pilsbot/overvoltage_protection/render/pcb.png

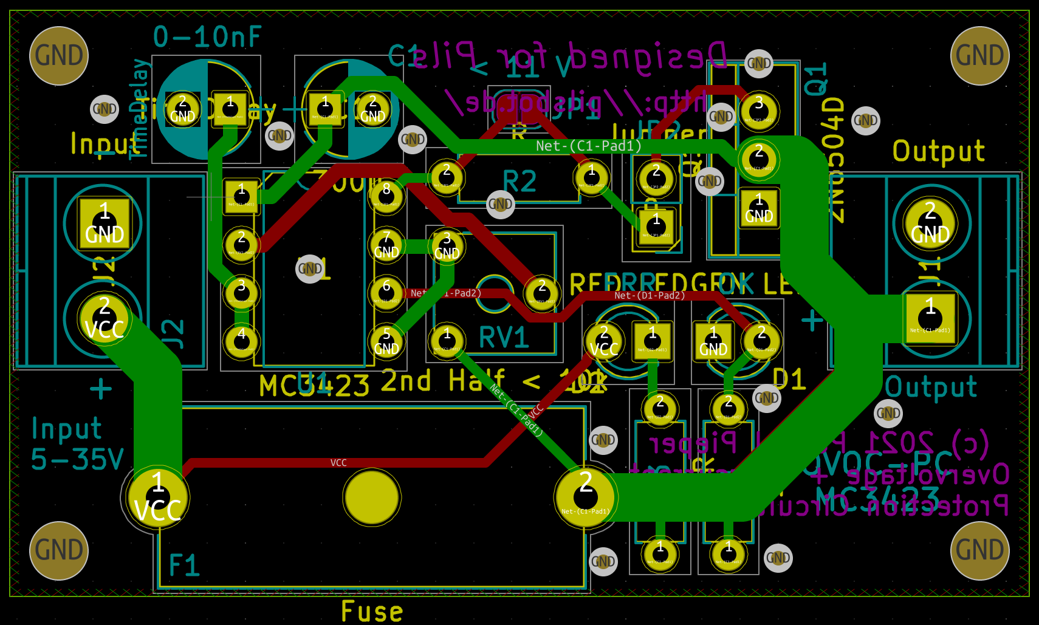
render/pcb.png
