pilsbot/overvoltage_protection/render/pcb_3d_bot.png

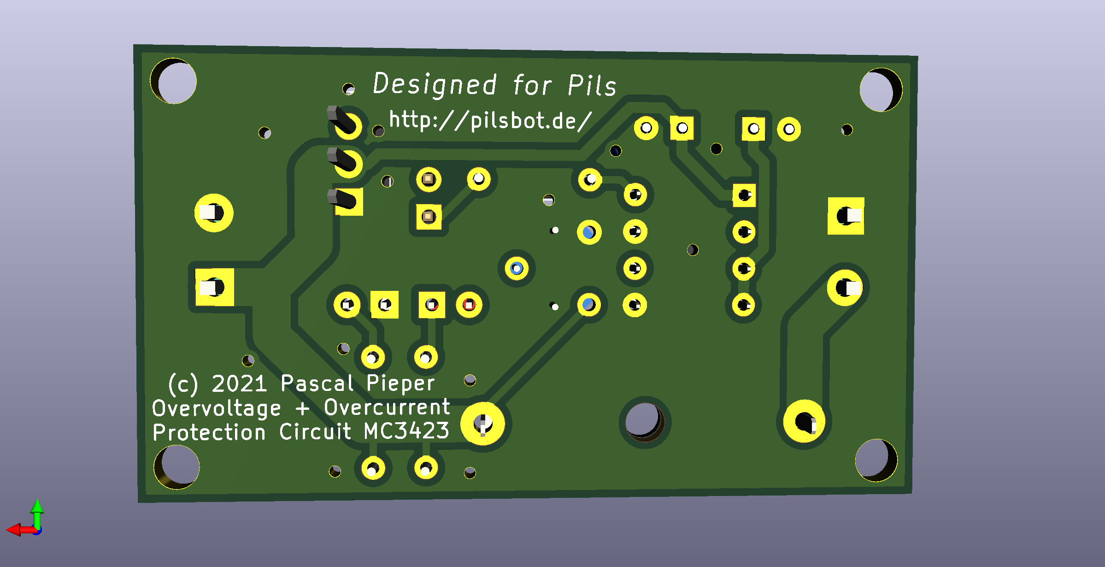
render/pcb_3d_bot.png
