pilsbot/overvoltage_protection/overvolt.kicad_pcb

## KiCad design overvolt.kicad_pcb (2021-06-11)

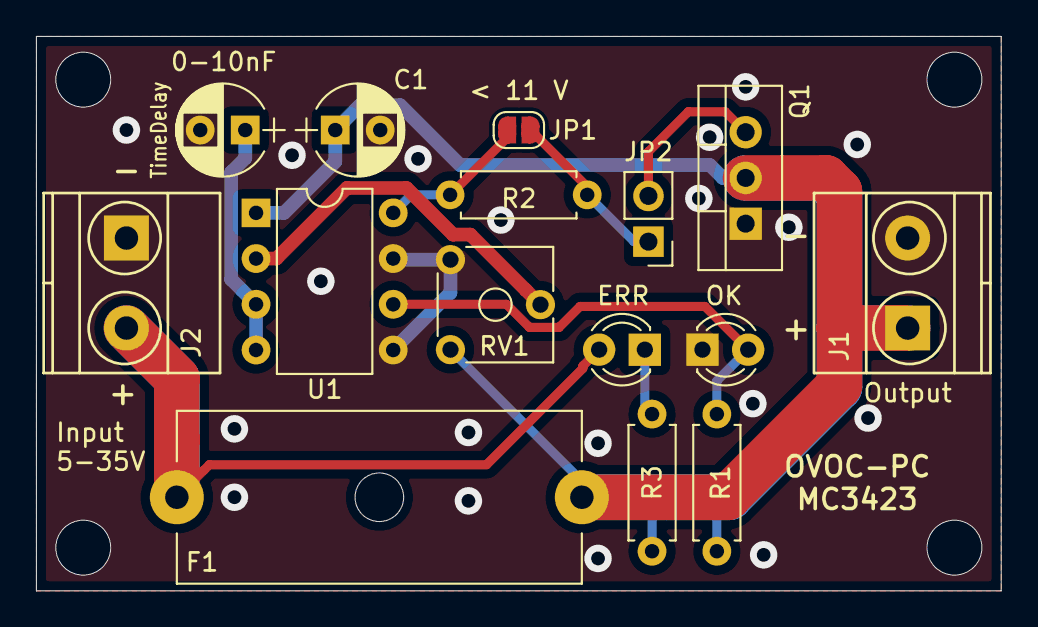
[picture p5: board overvolt.kicad_pcb from above]

Board: 2 copper layers, 53.6 x 30.8 mm, 15 parts (0 on the bottom side), 10 nets.

Parts:
C1: 300µ; CP_Radial_D5.0mm_P2.50mm
D1: GRN LED; LED_D3.0mm
D2: RED LED; LED_D3.0mm
F1: Fuse; Fuseholder5x20_horiz_open_Schurter_0031_8201
J1: Output; TerminalBlock_Phoenix_MKDS1.5-2pol
J2: Input; TerminalBlock_Phoenix_MKDS1.5-2pol
JP1: < 11 V; SolderJumper-2_P1.3mm_Open_RoundedPad1.0x1.5mm
JP2: Jumper; Pin_Header_Straight_1x02_Pitch2.54mm
Q1: 2N6504D; TO-220-3_Vertical
R1: 1k; R_Axial_DIN0207_L6.3mm_D2.5mm_P7.62mm_Horizontal
R2: R; R_Axial_DIN0207_L6.3mm_D2.5mm_P7.62mm_Horizontal
R3: 3kR; R_Axial_DIN0207_L6.3mm_D2.5mm_P7.62mm_Horizontal
RV1: 2nd Half < 10k; Potentiometer_Trimmer_ACP_CA6v_Horizontal
TimeDelay: 0-10nF; CP_Radial_D5.0mm_P2.50mm
U1: MC3423; DIP-8_W7.62mm

Connections:
GND: C1.2, D1.1, J1.2, J2.1, Q1.1, RV1.3, TimeDelay.2, U1.5, U1.7
unnamed: C1.1, F1.2, J1.1, Q1.2, R1.1, R3.1, RV1.1, U1.1
unnamed: D1.2, R1.2, U1.6
unnamed: D2.1, R3.2
unnamed: JP1.1, R2.2, U1.8
unnamed: JP1.2, JP2.1, R2.1
unnamed: JP2.2, Q1.3
unnamed: RV1.2, U1.2
unnamed: TimeDelay.1, U1.3, U1.4
VCC: D2.2, F1.1, J2.2
