pilsbot/overvoltage_protection/(threads)

Thread 1 (2021-06-21):

Red ERR LED has wrong polarity

Cirromulus, 2021-06-21:
The red "fuse burnt"-LED is set in the wrong direction.

**Solution:** Solder in opposite direction
