pilsbot/overvoltage_protection/(commit log)

2021-05-31 Initial Overvolt-PCB design
    [overvolt.kicad_pcb, overvolt.sch]
2021-06-11 PCB in factory, lets see the first results
    [overvolt-B_Cu.gbr, overvolt-B_Mask.gbr, overvolt-B_Paste.gbr, overvolt-B_SilkS.gbr, overvolt-Edge_Cuts.gbr, overvolt-F_Cu.gbr, overvolt-F_Mask.gbr, overvolt-F_Paste.gbr]
2021-06-11 Moved to own repo for external use
    [overvolt-B_Cu.gbr, overvolt-B_Mask.gbr, overvolt-B_Paste.gbr, overvolt-B_SilkS.gbr, overvolt-Edge_Cuts.gbr, overvolt-F_Cu.gbr, overvolt-F_Mask.gbr, overvolt-F_Paste.gbr]
2021-06-11 Repaired moving project
    [overvolt.sch]
2021-06-11 added BOM
    [overvolt_BOM.csv]
2021-06-23 Added real PCB image
2021-06-23 Info on red LED
