pilsbot/overvoltage_protection/(notices)

Notices in the files:
overvolt.kicad_pcb:
(c) 2021 Pascal Pieper
